ahdinosaur/furniture/workout/README.md

# workout rings frame

## bill of materials

- galvanized steel pipe (GPIP, 32mm nominal bore, 42.4mm outside diameter)
  - total 19.4m:
    - 2 x 3.0 m
    - 2 x 1.8 m
    - 3 x 1.6 m
    - 4 x 1.0 m
    - extra 3 x 0.1m
  - 1st and 2nd 6.5m:
    - 1 x 3.0 m
    - 1 x 1.8 m
    - 1 x 1.6 m
    - extra 0.1m
  - 3rd 6.5m :
    - 1 x 1.6 m
    - 4 x 1.0 m
    - 2 x 0.4 m
    - extra 0.1m
- connectors
  - 6 x 90° elbow
  - 2 x double swivel
  - 8 x adjustable tee 30-60
    - or 8 x single swivel
  - 2 x short tee

## assembly diagram
