ahdinosaur/furniture/(list of files, cad)

Other CAD files:
loft/stl/post-m6.stl
loft/stl/rail.stl
loft/stl/post-m8.stl
