ahdinosaur/furniture/(commit log)

2019-09-30 in the beginning, a workout frame
2019-12-22 commit to bed
2025-12-18 Loft (v1) (#1)
    [loft.scad]
2025-12-22 Loft (v2) (#2)
    [loft.scad]
2026-04-29 Loft v3 (#4)
    [loft.scad]
2026-04-29 Loft v4 (#5)
    [loft.scad]
2026-05-18 Loft v5 (#6)
    [loft.scad]
2026-05-18 Loft v6 (#7)
    [loft.scad]
2026-05-18 Improve the presentation, although sloppy
    [loft.scad]
2026-11-06 Loft README: clearer lamination, flag bolt/rung conflict
    - Split post image into uncut + cut, with no-screw zones table for
    side "b" so lamination screws miss the future housings
    - Flag safety-rail level 3 / rung 1 housing overlap on side "b"
    - Merge duplicate bed-frame sections; add bed-panel / support-panel /
    finish steps that were missing from Assembly
    - Add `post_blank` view + Justfile recipe for the new render
2026-11-06 Loft README: rewrite as build guide, fix crossing side-rail bolts
2026-11-07 Loft: jig-drilled bolt holes so every rail is interchangeable
    Replace drill-in-place (matched pairs) with jig-drilled holes. All bolt
    patterns are symmetric level pairs with centred holes, so any rail or
    support fits any slot any way round. Head-side holes snug (6.5 / 8.5),
    post holes loose (8 / 9.5). M8 for the bed frame on shelf blocks, M6
    for the rails. Nuts recessed 20 mm with a 25 mm Forstner; 130 mm bolts
    so no tip protrudes. Side rails move into the gaps between tiers, which
    matches the model and removes crossing bolts. Lower the ladder 20 mm
    (ladder_start 70) so the tier 3 recess clears rung 1. Bed panel gets
    notches to close the gap behind the side "a" posts.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
2026-11-07 Loft: keep rungs as built, lift lowest rail 40 and bed 20, drill through holes before recesses
    The ladder is already glued with rung 1 at 1800 to 1845, so the model goes
    back to ladder_start = 90. The tier 3 long rail moves up 40 mm to 1845 to
    1935 (bolt at 1890) so a drill body fits above rung 1 to cut the nut recess
    on the ladder's inner face. The bed frame moves up 20 mm with it so the rail
    still sits just above the bed panel. Gap above tier 3 is 50 mm, others 90.
    Posts are now drilled through from the part face with the jig, then the hole
    is plugged with dowel and the Forstner recess is cut on the plug, so the jig
    never has to sit on the rung face and the ladder can be glued first.
    Sid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
2026-11-07 Loft: model the four drilling jigs and render them into the README
    loft/jigs.scad draws the POST M6, POST M8, RAIL and SUPPORT saddle jigs,
    plus a POST jig sitting on a post and a RAIL jig on a rail end. Three new
    Justfile recipes render them; the README jig section uses the images in
    place of the ASCII sketch.
2026-11-07 Loft: heads inside, nuts recessed in the rails, 10 mm M8 post holes
    Flip every bolt so the head sits on the post's inner face and the nut
    recess is cut into the rail's outer face on the bench. Nothing is cut
    into the ladder's rung face any more, so tier 3 drops to a 20 mm lift
    (1825-1915, bolt 1870) and the bed frame returns to the original
    1715 joist bottom. Gaps 90/90/70.
    Hole sizes follow the heads: post 6.5 (M6 head side), rail 8, support
    8.5, post 10 (M8 nut side). Second Big Gator guide (10-14 mm) added.
    Recesses go in before the through hole, on a dimple from the jig, so
    the dowel plugs are gone. Fit rails by pushing the bolts through the
    post first and hanging the rail on them.
    Kee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
2026-11-07 Loft: drill one master per rail family and copy the rest, so rail length no longer matters
    The RAIL and SUPPORT jigs registered off the end of the timber, which
    assumed every rail was cut to length within about 1 mm. As cut they are a
    few mm out, and the side "b" support has to match the ladder as built.
    - Side "b" support is drilled through the post holes on the ladder with
    an 8.5 mm bit. Side "a" support and the 3 side rails are copied from it.
    - The longest long rail is drilled with the RAIL jig and the other 7 are
    copied from it: dimple through the master, Forstner, drill through.
    - SUPPORT jig and the 150 mm 8.5 bit are gone. 8.5 x 200 added.
    - New rail-copy render and view; jigs r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
2026-11-07 Loft: 3D printed jigs that hold the Big Gator guide bar in two pockets
    The plastic places the steel, the steel guides the bit. Each jig has two
    pockets 40 mm apart and one bar moves between them. The RAIL jig turns the
    pockets across the rail so they don't overlap. Three ruler readings (hole
    centre from the bar end) go into jigs.scad before printing. STLs exported
    flat side down into loft/stl via just loft-stl-all.
2026-11-07 Loft jigs: taper the pockets to match the Big Gator bars
    The bars are about 22 wide at the top and 14 at the bottom. Straight pocket
    walls 15 mm tall only touched the bar where it is 19.6 wide, leaving 3 mm of
    side play that would spoil the 40 mm hole spacing. Pockets now taper like
    the bar, loose at the bottom and snug at the wall top, so the bar centres on
    the top edge of the wall. Bar sizes gain a bottom width reading.
2026-11-07 Loft jigs: take the MDG1000NP hole positions from a community CAD model
    6.5 hole at 61.5 and 8 hole at 97 from the small end, instead of guesses of
    78 and 110. The model is a simplified shape and 137 long against the 139.7
    spec, so the README still asks for a ruler check.
2026-11-07 Loft README: MDG2000NP numbers are guesses, print POST M8 after measuring it
2026-11-08 Loft README: standard long series bits are long enough, no need for 200 mm
2026-11-08 Loft README: drill rail copies through the template so the holes stay straight
2026-11-08 Loft: model the notched bed panel and its breathing holes, rewrite the panel cut guide
2026-11-08 Loft: bolt the support panels as racking braces, 16 more M6, panel heights clear of rungs and a future bunk
